loganvaught/Klaus/Media/Images/lid_open.png

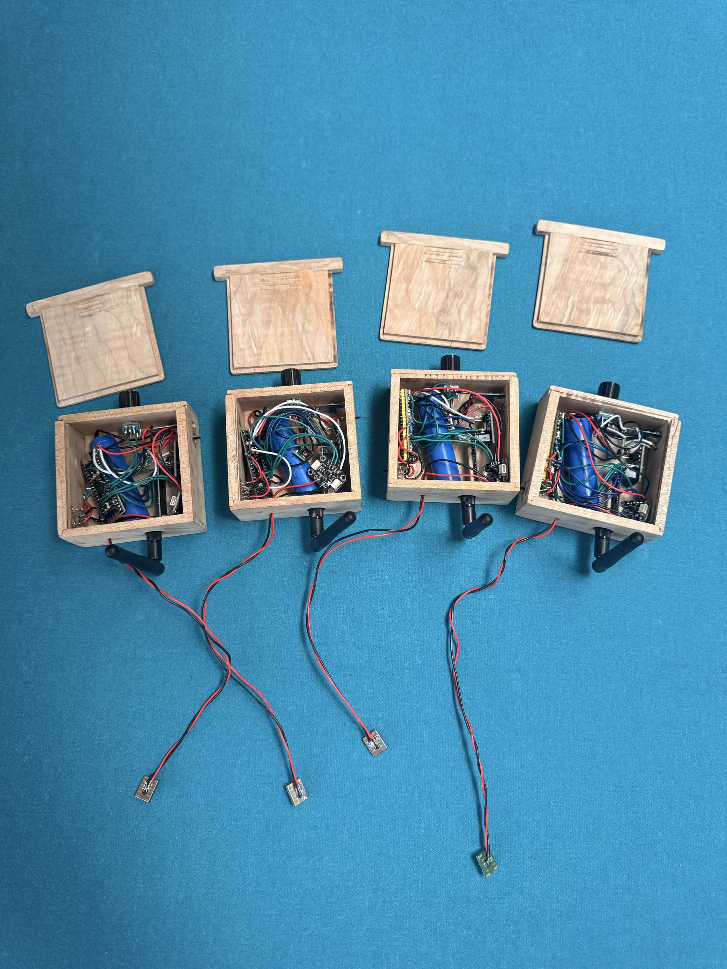
Media/Images/lid_open.png
