loganvaught/Klaus/Klaus/Core/Src/main.c

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
/* Includes ------------------------------------------------------------------*/
#include "main.h"

/* USER CODE BEGIN Includes */
#include "drv2605l.h"
#include "nrf24l01.h"
#include "metronome.h"

/* USER CODE END Includes */

/* USER CODE BEGIN PD */

#define RF_CHANNEL 92
#define DRV2605L_WAVEFORM_USE 4

/* USER CODE END PD */

I2C_HandleTypeDef hi2c1;

SPI_HandleTypeDef hspi1;

TIM_HandleTypeDef htim3;
TIM_HandleTypeDef htim5;

UART_HandleTypeDef huart1;

void SystemClock_Config(void);
static void MX_GPIO_Init(void);
static void MX_I2C1_Init(void);
static void MX_USART1_UART_Init(void);
static void MX_SPI1_Init(void);
static void MX_TIM3_Init(void);
static void MX_TIM5_Init(void);
/* USER CODE BEGIN 0 */

// Redirect printf through UART
int _write(int fd, char* ptr, int len) {
	HAL_StatusTypeDef hstatus;

	if (fd == 1 || fd == 2) {
	  hstatus = HAL_UART_Transmit(&huart1, (uint8_t *) ptr, len, HAL_MAX_DELAY);
	  if (hstatus == HAL_OK)
		return len;
	  else
		return -1;
	}
	return -1;
}

uint8_t encoder_last_state = 0;
uint8_t encoder_state = 0;
volatile uint8_t encoder_change = 2;

// Arrays to differentiate between "noise" and a real, encoder direction
uint8_t encoder_clockwise_dict[4] = {
		2, 0, 3, 1
};
uint8_t encoder_counterclockwise_dict[4] = {
		1, 3, 0, 2
};

volatile uint8_t nrf_irq_pending = 0;
volatile uint8_t btn_pressed = 0;

void HAL_GPIO_EXTI_Callback(uint16_t GPIO_Pin) {
	if (GPIO_Pin == ENCODER_A_Pin || GPIO_Pin == ENCODER_B_Pin) {
		encoder_change = 1;
	}
	else if (GPIO_Pin == NRF_IRQ_Pin) {
		nrf_irq_pending = 1;
	}
	else if (GPIO_Pin == BTN_Pin) {
		btn_pressed = 1;
	}
}

// 6-byte array used for transmitting RF synchronization packets
uint8_t rf_buff[6] = {
		// 1 = BPM, MSB
		// 2 = BPM, LSB
		// 3 = Master timestamp, MSB
		// 6 = Master timestamp, LSB
};

// RF CALLBACKS
uint8_t packet_received = 0;
void rx_callback(uint8_t *data, uint16_t length) {
	if (length == (sizeof(rf_buff) / sizeof(rf_buff[0]))) {
		for (int i = 0; i < length; i ++) {
			rf_buff[i] = data[i];
		}
		packet_received = 1;
	}
	else {
		MAIN_DBG("Received data of unexpected length.\r\n");
		Error_Handler();
	}
}

uint8_t packet_sent = 0;
void tx_callback() {
	packet_sent = 1;
}

// Handles to interact with drivers / custom libraries
drv2605l_handle_t haptic_driver;
nrf24l01_handle_t rf_handle;
metronome_t metronome;

// METRONOME CALLBACK
void pulse_callback(uint16_t tempo, uint32_t timestamp) {
	if (rf_handle.mode != NRF24L01_RX) {
		HAL_GPIO_TogglePin(LED_GPIO_Port, LED_Pin);
	}

	drv2605l_play(&haptic_driver, DRV2605L_WAVEFORM_USE);

	if (rf_handle.mode == NRF24L01_TX) {
		rf_buff[0] = tempo >> 8;
		rf_buff[1] = tempo & 0xFF;
		rf_buff[2] = timestamp >> 24;
		rf_buff[3]= (timestamp >> 16) & 0xFF;
		rf_buff[4]= (timestamp >> 8) & 0xFF;
		rf_buff[5]= timestamp & 0xFF;

		nrf24l01_result_t nrf24l01_result = nrf24l01_transmit(&rf_handle, rf_buff, 6);
		if (nrf24l01_result != NRF24L01_OK) {
			MAIN_DBG("Error when transmitting\r\n");
		}
	}
}

/* USER CODE END 0 */

/**
  * @brief  The application entry point.
  * @retval int
  */
int main(void)
{

  /* MCU Configuration--------------------------------------------------------*/

  /* Reset of all peripherals, Initializes the Flash interface and the Systick. */
  HAL_Init();

  /* Configure the system clock */
  SystemClock_Config();

  /* Initialize all configured peripherals */
  MX_GPIO_Init();
  MX_I2C1_Init();
  MX_USART1_UART_Init();
  MX_SPI1_Init();
  MX_TIM3_Init();
  MX_TIM5_Init();

  /* USER CODE BEGIN 2 */

  MAIN_DBG("\r\nWorking!\r\n");

  // -------------- DRV2605L setup -------------- //

  drv2605l_init(&haptic_driver, &hi2c1);

  // -------------- NRF24L01+ setup -------------- //

  micro_delay_handle_t micro_timer;
  HAL_TIM_Base_Start(&htim3);
  micro_delay_init(&micro_timer, &htim3);
  uint8_t channel = RF_CHANNEL;
  nrf24l01_datarate_t data_rate = NRF24L01_DR_250KBPS;
  nrf24l01_power_t power = NRF24L01_PWR_0DBM;
  uint8_t pipe_address[5] = {0x55,0x4E,0x55,0x4E,0x55,};
  nrf24l01_result_t nrf24l01_result;
  nrf24l01_result = nrf24l01_init(&rf_handle, &hspi1, &micro_timer, NRF_CS_GPIO_Port, NRF_CS_Pin, NRF_CE_GPIO_Port, NRF_CE_Pin, channel, data_rate, power, pipe_address);
  if (nrf24l01_result != NRF24L01_OK) {
	  MAIN_DBG("Error when initializing nrf24l01\r\n");
	  Error_Handler();
  }
  else {
	  MAIN_DBG("Initialized RF right!\r\n");
  }

  rf_handle.rx_callback = rx_callback;
  rf_handle.tx_callback = tx_callback;

  // -------------- Metronome setup -------------- //

  HAL_TIM_Base_Start_IT(&htim5);
  metronome_init(&metronome, &htim5);
  metronome.pulse_callback = pulse_callback;

  /* USER CODE END 2 */

  /* Infinite loop */
  /* USER CODE BEGIN WHILE */

  while (1)
  {
	  //---------------------------- ENCODER CODE ------------------------------//
	  if (encoder_change == 2) { // First time initializing encoder variables
		  encoder_change = 0;
		  encoder_state = (HAL_GPIO_ReadPin(ENCODER_A_GPIO_Port, ENCODER_A_Pin) << 1) | HAL_GPIO_ReadPin(ENCODER_B_GPIO_Port, ENCODER_B_Pin);
		  encoder_last_state = encoder_state;
	  }

	  if (encoder_change) {
		  if (rf_handle.mode != NRF24L01_RX) { // Ensure not in RX mode
			  encoder_state = (HAL_GPIO_ReadPin(ENCODER_A_GPIO_Port, ENCODER_A_Pin) << 1) | HAL_GPIO_ReadPin(ENCODER_B_GPIO_Port, ENCODER_B_Pin);
			  metronome_direction_t direction;
			  if (encoder_clockwise_dict[encoder_last_state] == encoder_state) {
				  // Clockwise
				  direction = METRONOME_FORWARD;
			  }
			  else if (encoder_counterclockwise_dict[encoder_last_state] == encoder_state) {
				  // Counterclockwise
				  direction = METRONOME_BACKWARD;
			  }
			  else {
				  // Noise
				  direction = METRONOME_NONE;
			  }

			  if (encoder_state == 0) { // Encoder has detents. Check for completed detent
				  metronome_change_tempo(&metronome, direction);
			  }

			  encoder_last_state = encoder_state;
		  }
		  encoder_change = 0;
	  }

	  //---------------------------- nRF24L01+ CODE ------------------------------//

	  if (nrf_irq_pending) {
		  nrf_irq_pending = 0;
		  nrf24l01_result = nrf24l01_handle_irqs(&rf_handle);
		  if (nrf24l01_result != NRF24L01_OK) {
			  Error_Handler();
		  }
	  }

	  if (btn_pressed) {
		  // Reset the offset and re-initialize timestamps for smoother mode change
		  metronome_reset_rf(&metronome);
		  switch (rf_handle.mode) {
		  case NRF24L01_RX: // Entering standby mode
			  nrf24l01_result = nrf24l01_enter_standby(&rf_handle);
			  if (nrf24l01_result != NRF24L01_OK) {
				  MAIN_DBG("Error when entering off\r\n");
			  }
			  HAL_GPIO_WritePin(RF_LED_TX_GPIO_Port, RF_LED_TX_Pin, GPIO_PIN_RESET);
			  HAL_GPIO_WritePin(RF_LED_RX_GPIO_Port, RF_LED_RX_Pin, GPIO_PIN_RESET);
			  break;
		  case NRF24L01_Standby: // Entering TX mode
			  nrf24l01_result = nrf24l01_enter_tx(&rf_handle);
			  if (nrf24l01_result != NRF24L01_OK) {
				  MAIN_DBG("Error when entering TX\r\n");
			  }
			  HAL_GPIO_WritePin(RF_LED_TX_GPIO_Port, RF_LED_TX_Pin, GPIO_PIN_SET);
			  HAL_GPIO_WritePin(RF_LED_RX_GPIO_Port, RF_LED_RX_Pin, GPIO_PIN_RESET);
			  break;
		  case NRF24L01_TX: // Entering RX mode
			  nrf24l01_result = nrf24l01_enter_rx(&rf_handle);
			  if (nrf24l01_result != NRF24L01_OK) {
				  MAIN_DBG("Error when entering RX\r\n");
			  }
			  HAL_GPIO_WritePin(RF_LED_RX_GPIO_Port, RF_LED_RX_Pin, GPIO_PIN_SET);
			  HAL_GPIO_WritePin(RF_LED_TX_GPIO_Port, RF_LED_TX_Pin, GPIO_PIN_RESET);
			  break;
		  default:
			  MAIN_DBG("Invalid button mode\r\n");
			  Error_Handler();
		  }

		  // Debounce to avoid button press registering as multiple mode changes
		  HAL_Delay(10);
		  btn_pressed = 0;
	  }

	  //---------------------------- METRONOME CODE ------------------------------//

	  metronome_update(&metronome);

	  if (packet_received) {
		  packet_received = 0;
		  HAL_GPIO_TogglePin(LED_GPIO_Port, LED_Pin);

		  uint16_t tempo = rf_buff[0] << 8 | rf_buff[1];
		  uint32_t master_timestamp = rf_buff[2] << 24 | rf_buff[3] << 16 | rf_buff[4] << 8 | rf_buff[5];

		  metronome_process_rf(&metronome, tempo, master_timestamp);
	  }

	  if (packet_sent) {
		  MAIN_DBG("Successfully sent data\r\n");
		  packet_sent = 0;
	  }

    /* USER CODE END WHILE */

    /* USER CODE BEGIN 3 */
  }
  /* USER CODE END 3 */
}

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
