loganvaught/Klaus/(commit log)

2026-05-28 Initialize project with STM32CubeIDE
2026-05-30 Added functions for DRV2605L haptic driver. Cycles through all 123 licensed waveforms.
2026-06-02 Added debug print for rotary encoder with timer in encoder mode
2026-06-02 Added state machine for encoder instead of timer. Checks for detents, updates a tempo variable
2026-06-03 Added metronome buzzing with timer, adjusts with tempo from rotary encoder.
    [Klaus.ioc, main.c]
2026-06-11 Added DRV2605L code to driver
2026-06-13 Improved driver code for DRV2605L
2026-06-13 Fix driver organization
2026-06-23 Added NRF24L01+ driver, improved naming in DRV2605L driver. Main.c not functional for NRF yet.
2026-07-04 Fully functional RF syncing across multiple devices. User button changes mode.
2026-07-07 Fixed critical error in timing of PWR_UP.
    [main.c, nrf24l01.c]
2026-07-29 Finalize code, remove unnecessary comments, add DEBUG check. Use software debounce to make button presses only register as 1 press
2026-07-29 Update README with more relevant info
    Clarified note about block diagram and updated terminology for driver initialization.
2026-07-31 Video attachment change
2026-10-17 Fixed bugs: Added volatile keyword to ISR flags, accounted for timer wrap around when checking pulse, fixed some comments
